PasanBhanu/arduino-adjustable-over-current-relay/README.md

## Adjustable Over Current Relay Using Arduino & ACS712 Current Sensor

### Introduction
This project is for creating an Adjustable Over Current Relay Using Arduino & ACS712 Current Sensor. All the details under this project published in this GIT. Fell free to use this and create your own adjustable over current protector for your projects or labs.

### Support

Email : pasanbguruge@hotmail.com
Mail me with your issue.
