PasanBhanu/arduino-adjustable-over-current-relay/(list of files, drawings)

Other design files:
Proteus Simulation/EE 2/EE 2.pdsprj
