PasanBhanu/arduino-adjustable-over-current-relay/(commit log)

2018-07-16 Arduino Code
2018-07-16 Simualation In Proteus
    [EE 2.pdsprj]
